DepartmentOfAlchemy/Codex43/board/Codex43/Codex43.kicad_pcb

## KiCad design board/Codex43/Codex43.kicad_pcb (2024-08-17)

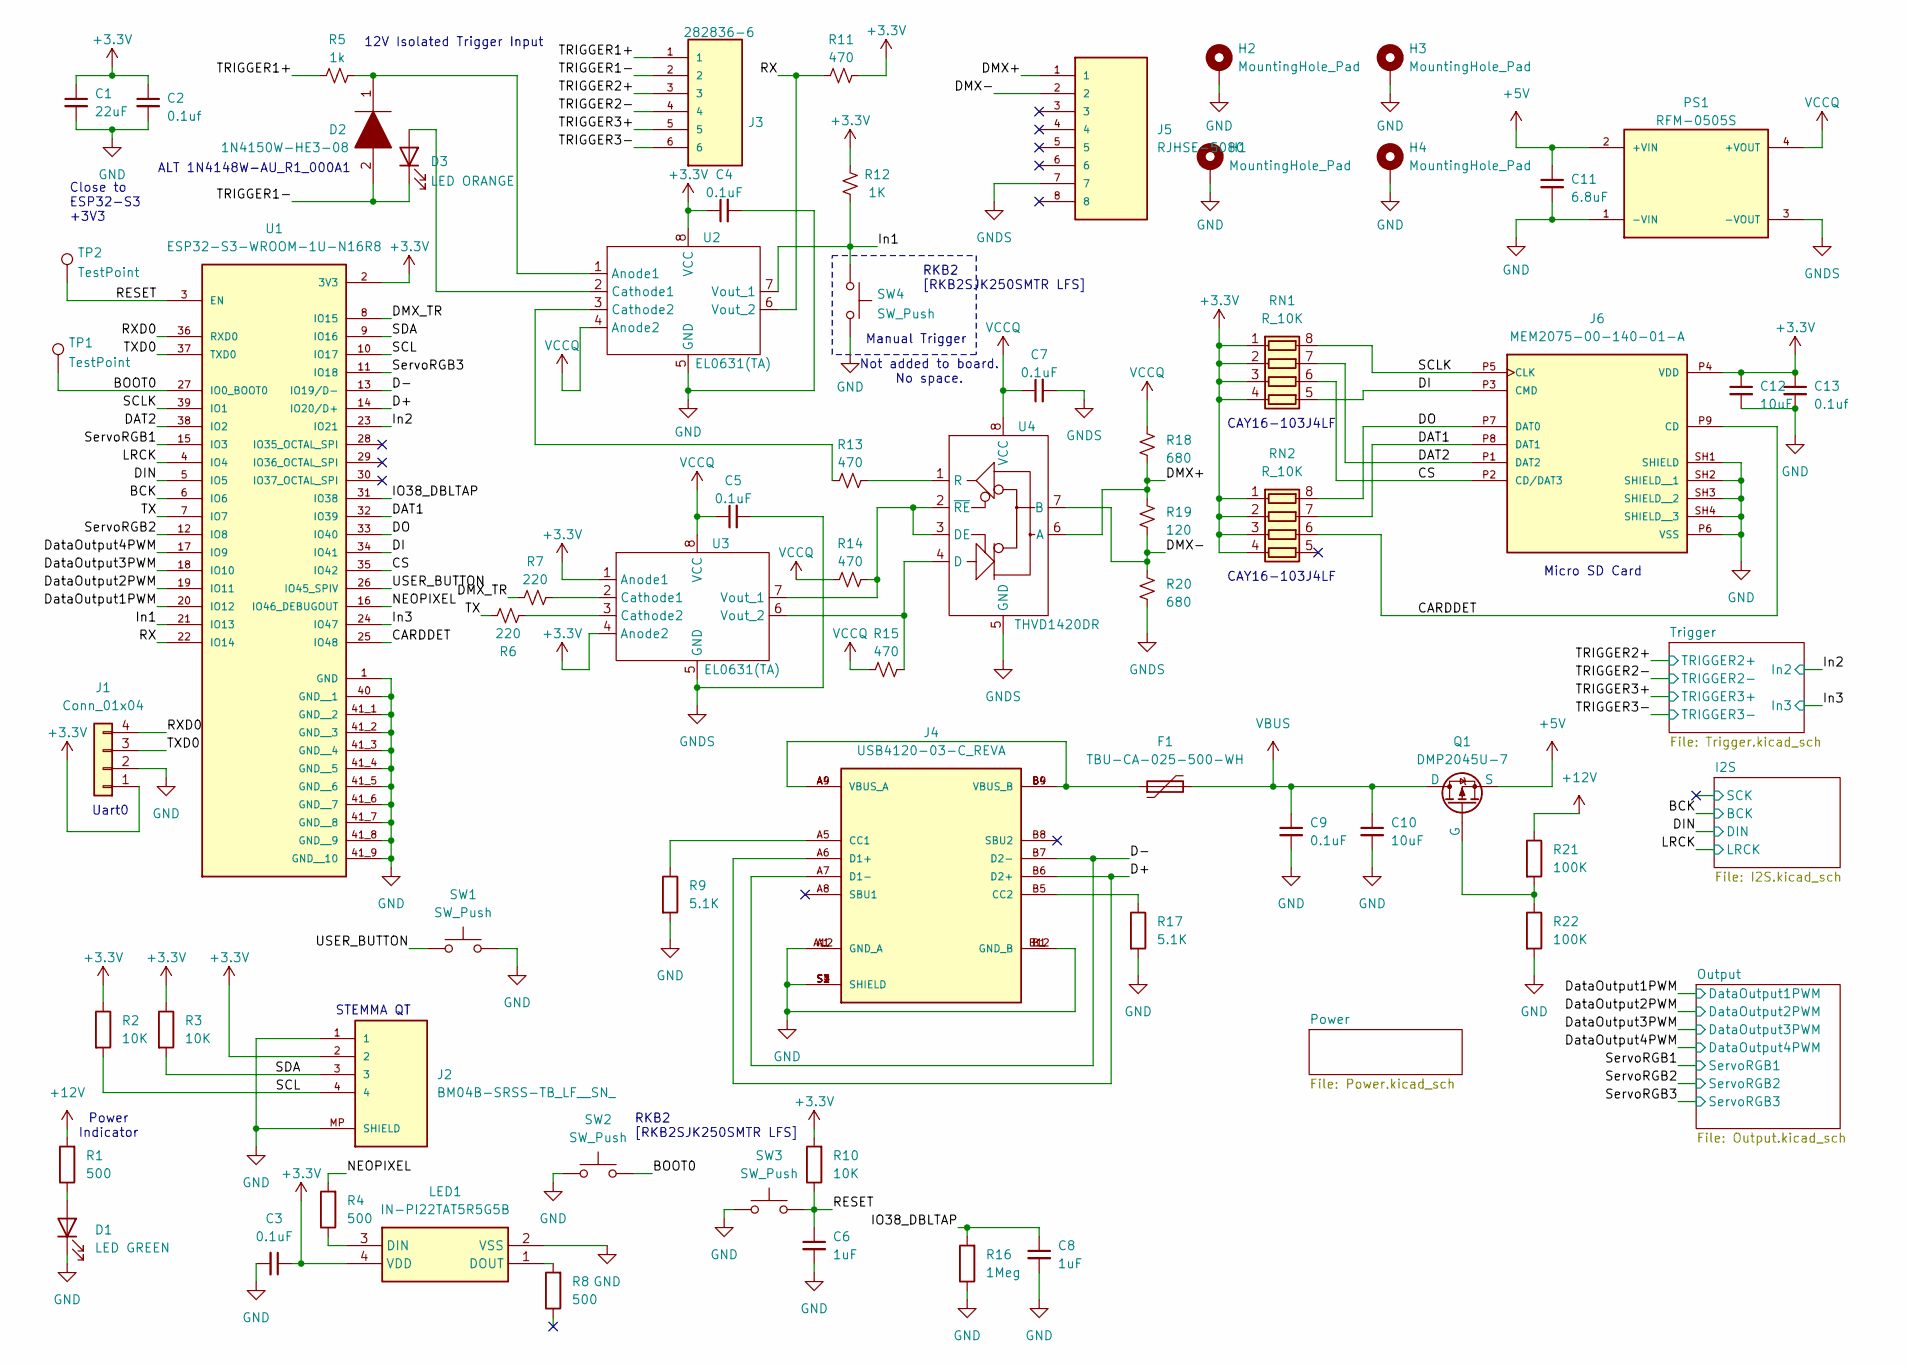
[picture p1: schematic Codex43.kicad_sch, Codex 43]

Parts:
C1: 22uF; C_0805_2012Metric
C2, C13: 0.1uf; C_0603_1608Metric
C3, C4, C5, C7, C9: 0.1uF; C_0603_1608Metric
C6, C8: 1uF; C_0603_1608Metric
C10, C12: 10uF; C_0805_2012Metric
C11: 6.8uF; C_0805_2012Metric
D1: LED GREEN; LED_0603_1608Metric
D2: 1N4150W-HE3-08; D_SOD-123; Manufacturer_Part_Number S1GTR
D3: LED ORANGE; LED_0603_1608Metric
F1: TBU-CA-025-500-WH; Fuse_Bourns_TBU-CA
H1, H2, H3, H4: MountingHole_Pad; MountingHole_3.2mm_M3_ISO7380_Pad_TopBottom
J1: Conn_01x04; PinHeader_1x04_P2.54mm_Vertical
J2: BM04B-SRSS-TB_LF__SN_; JST_SH_BM04B-SRSS-TB_1x04-1MP_P1.00mm_Vertical; PARTREV N/A
J3: 282836-6; TE_282836-6; PARTREV J1
J4: USB4120-03-C_REVA; GCT_USB4120-03-C_REVA; PARTREV A
J5: RJHSE-5080; AMPHENOL_RJHSE-5080; PARTREV G
J6: MEM2075-00-140-01-A; GCT_MEM2075-00-140-01-A; PARTREV A
LED1: IN-PI22TAT5R5G5B; INPI22TAT5R5G5B; Mouser Part Number 743-IN-PI22TAT5R5G5B
PS1: RFM-0505S; CONV_RFM-0505S; PARTREV 0
Q1: DMP2045U-7; SOT-23_DIO
R1, R4, R8: 500; R_0603_1608Metric
R2, R3, R10: 10K; R_0603_1608Metric
R5: 1k; R_0603_1608Metric
R6, R7: 220; R_0603_1608Metric
R9, R17: 5.1K; R_0603_1608Metric
R11, R13, R14, R15: 470; R_0603_1608Metric
R12: 1K; R_0603_1608Metric
R16: 1Meg; R_0603_1608Metric
R18, R20: 680; R_0603_1608Metric
R19: 120; R_0603_1608Metric
R21, R22: 100K; R_0603_1608Metric
RN1, RN2: R_10K; R_Array_Convex_4x0603
SW1, SW2, SW3, SW4: SW_Push; SW_Push_1P1T_NO_RKB2SJK250SMTR LFS
TP1, TP2: TestPoint; TestPoint_Pad_D2.5mm
U1: ESP32-S3-WROOM-1U-N16R8; XCVR_ESP32-S3-WROOM-1U-N16R8; PARTREV v1.1
U2, U3: EL0631(TA); EL0631(TA)-SOP-8_3.9x4.9mm_P1.27mm
U4: THVD1420DR; SOIC-8-TE_3.9x4.9mm_P1.27mm

Connections:
+3.3V: C1.1, C2.1, C3.1, C4.1, C12.1, C13.1, J1.1, J2.2, J6.P4 (VDD), LED1.4 (VDD), R2.1, R3.1, R10.2, R11.1, R12.2, RN1.1 (R1.1), RN1.2 (R2.1), RN1.3 (R3.1), RN1.4 (R4.1), RN2.1 (R1.1), RN2.2 (R2.1), RN2.3 (R3.1), RN2.4 (R4.1), U1.2 (3V3), U2.8 (VCC), U3.1 (Anode1), U3.4 (Anode2); also elsewhere on the board
+5V: C11.1, PS1.2 (+VIN), Q1.2 (S); also elsewhere on the board
+12V: R1.2, R21.1; also elsewhere on the board
/BCK: U1.6 (IO6); also elsewhere on the board
/BOOT0: SW2.2, TP1.1, U1.27 (IO0_BOOT0)
/CARDDET: J6.P9 (CD), RN2.6 (R3.2), U1.25 (IO48)
/CS: J6.P2 (CD/DAT3), RN1.6 (R3.2), U1.35 (IO42)
/D+: J4.A6 (D1+), J4.B6 (D2+), U1.14 (IO20/D+)
/D-: J4.A7 (D1-), J4.B7 (D2-), U1.13 (IO19/D-)
/DAT1: J6.P8 (DAT1), RN2.7 (R2.2), U1.32 (IO39)
/DAT2: J6.P1 (DAT2), RN1.7 (R2.2), U1.38 (IO2)
/DI: J6.P3 (CMD), RN1.5 (R4.2), U1.34 (IO41)
/DIN: U1.5 (IO5); also elsewhere on the board
/DMX+: J5.1, R18.2, R19.1, U4.6 (A)
/DMX-: J5.2, R19.2, R20.1, U4.7 (B)
/DMX_TR: R7.2, U1.8 (IO15)
/DO: J6.P7 (DAT0), RN2.8 (R1.2), U1.33 (IO40)
/DataOutput1PWM: U1.20 (IO12); also elsewhere on the board
/DataOutput2PWM: U1.19 (IO11); also elsewhere on the board
/DataOutput3PWM: U1.18 (IO10); also elsewhere on the board
/DataOutput4PWM: U1.17 (IO9); also elsewhere on the board
/IO38_DBLTAP: C8.1, R16.2, U1.31 (IO38)
/In1: R12.1, SW4.1, U1.21 (IO13), U2.7 (Vout_1)
/In2: U1.23 (IO21); also elsewhere on the board
/In3: U1.24 (IO47); also elsewhere on the board
/LRCK: U1.4 (IO4); also elsewhere on the board
/NEOPIXEL: R4.2, U1.16 (IO46_DEBUGOUT)
/RESET: C6.1, R10.1, SW3.2, TP2.1, U1.3 (EN)
/RX: R11.2, U1.22 (IO14), U2.6 (Vout_2)
/RXD0: J1.4, U1.36 (RXD0)
/SCL: J2.4, R2.2, U1.10 (IO17)
/SCLK: J6.P5 (CLK), RN1.8 (R1.2), U1.39 (IO1)
/SDA: J2.3, R3.2, U1.9 (IO16)
/ServoRGB1: U1.15 (IO3); also elsewhere on the board
/ServoRGB2: U1.12 (IO8); also elsewhere on the board
/ServoRGB3: U1.11 (IO18); also elsewhere on the board
/TRIGGER1+: J3.1, R5.2
/TRIGGER1-: D2.2, D3.1 (K), J3.2
/TRIGGER2+: J3.3; also elsewhere on the board
/TRIGGER2-: J3.4; also elsewhere on the board
/TRIGGER3+: J3.5; also elsewhere on the board
/TRIGGER3-: J3.6; also elsewhere on the board
/TX: R6.2, U1.7 (IO7)
/TXD0: J1.3, U1.37 (TXD0)
/USER_BUTTON: SW1.1, U1.26 (IO45_SPIV)
GND: C1.2, C2.2, C3.2, C4.2, C6.2, C8.2, C9.2, C10.2, C11.2, C12.2, C13.2, D1.1 (K), H1.1, H2.1, H3.1, H4.1, J1.2, J2.1, J2.MP (SHIELD), J4.A1 (GND_A), J4.A12 (GND_A), J4.B1 (GND_B), J4.B12 (GND_B), J4.S1 (SHIELD), J4.S2 (SHIELD), J4.S3 (SHIELD), J4.S4 (SHIELD), J6.P6 (VSS), J6.SH1 (SHIELD), J6.SH2 (SHIELD__1), J6.SH3 (SHIELD__2), J6.SH4 (SHIELD__3), LED1.2 (VSS), PS1.1 (-VIN), R9.2, R16.1, R17.2, R22.2, SW1.2, SW2.1, SW3.1, SW4.2, U1.1 (GND), U1.40 (GND__1), U1.41_1 (GND__2), U1.41_2 (GND__3), U1.41_3 (GND__4), U1.41_4 (GND__5), U1.41_5 (GND__6), U1.41_6 (GND__7), U1.41_7 (GND__8), U1.41_8 (GND__9), U1.41_9 (GND__10), U2.5 (GND); also elsewhere on the board
GNDS: C5.2, C7.2, J5.7, PS1.3 (-VOUT), R20.2, U3.5 (GND), U4.5 (GND)
unnamed: D1.2 (A), R1.1
unnamed: D3.2 (A), U2.2 (Cathode1)
unnamed: F1.1, J4.A4 (VBUS_A), J4.A9 (VBUS_A), J4.B4 (VBUS_B), J4.B9 (VBUS_B)
unnamed: J4.A5 (CC1), R9.1
unnamed: J4.B5 (CC2), R17.1
unnamed: LED1.3 (DIN), R4.1
unnamed: LED1.1 (DOUT), R8.2
unnamed: Q1.1 (G), R21.2, R22.1
unnamed: D2.1, R5.1, U2.1 (Anode1)
unnamed: R13.2, U2.3 (Cathode2)
unnamed: R7.1, U3.2 (Cathode1)
unnamed: R6.1, U3.3 (Cathode2)
unnamed: R14.1, U3.7 (Vout_1), U4.2 (~RE), U4.3 (DE)
unnamed: R15.1, U3.6 (Vout_2), U4.4 (D)
unnamed: R13.1, U4.1 (R)
VBUS: C9.1, C10.1, F1.3, Q1.3 (D)
VCCQ: C5.1, C7.1, PS1.4 (+VOUT), R14.2, R15.2, R18.1, U2.4 (Anode2), U3.8 (VCC), U4.8 (VCC)

Notes on the sheet:
RKB2 [RKB2SJK250SMTR LFS]
CAY16-103J4LF
Manual Trigger
Micro SD Card
Not added to board. No space.
Power Indicator
Close to ESP32-S3 +3V3
STEMMA QT
12V Isolated Trigger Input
ALT 1N4148W-AU_R1_000A1
Uart0

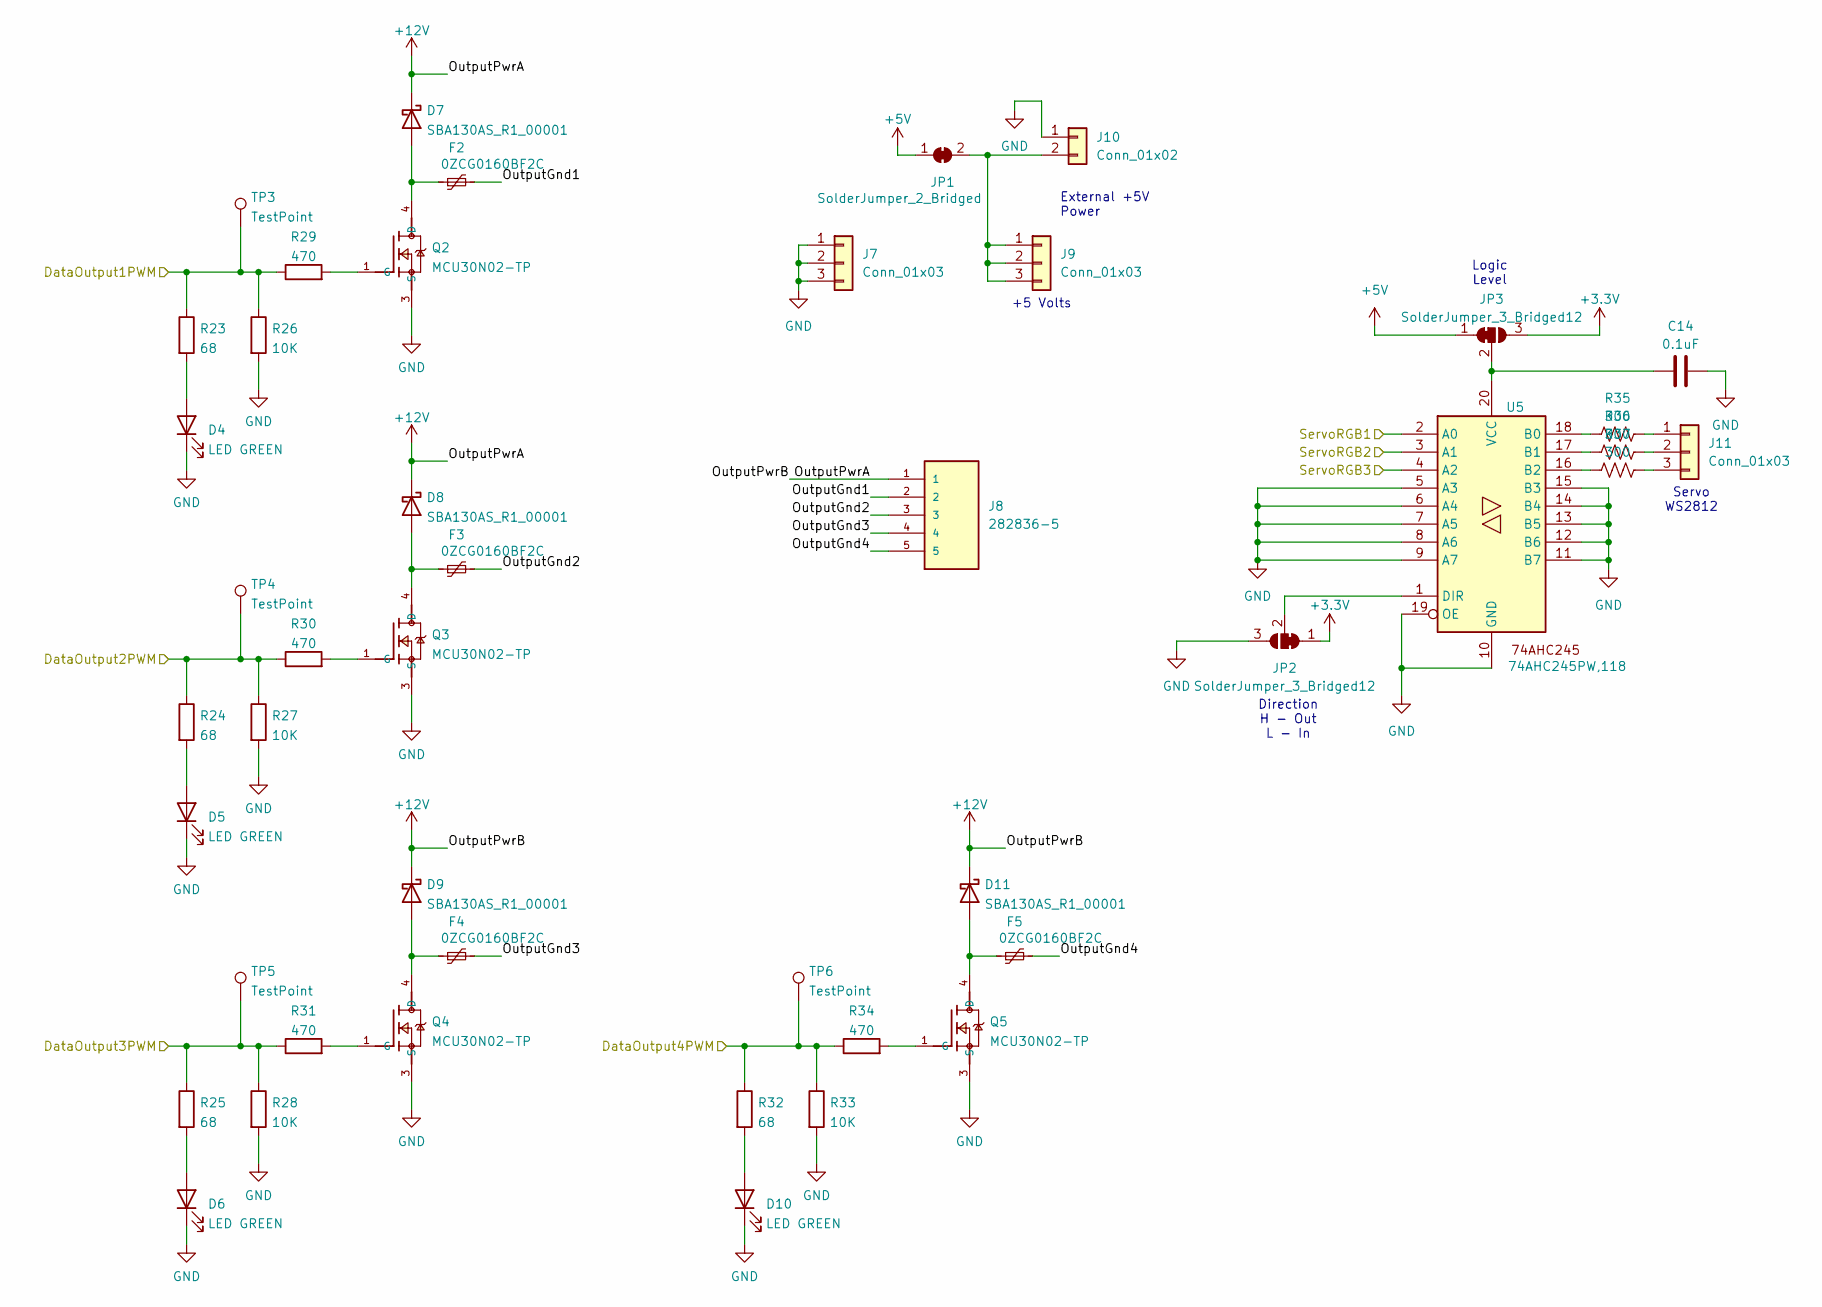
[picture p2: schematic Output.kicad_sch, Codex 43]

Parts:
C14: 0.1uF; C_0805_2012Metric_Pad1.18x1.45mm_HandSolder
D4, D5, D6, D10: LED GREEN; LED_0603_1608Metric
D7, D8, D9, D11: SBA130AS_R1_00001; D_SOD-123
F2, F3, F4, F5: 0ZCG0160BF2C; Fuse_1812_4532Metric
J7, J9, J11: Conn_01x03; PinHeader_1x03_P2.54mm_Vertical
J8: 282836-5; TE_282836-5; PARTREV J1
J10: Conn_01x02; PinHeader_1x02_P2.54mm_Vertical
JP1: SolderJumper_2_Bridged; SolderJumper-2_P1.3mm_Bridged_Pad1.0x1.5mm
JP2, JP3: SolderJumper_3_Bridged12; SolderJumper-3_P1.3mm_Bridged12_Pad1.0x1.5mm
Q2, Q3, Q4, Q5: MCU30N02-TP; TO229P991X239-3N
R23, R24, R25, R32: 68; R_0603_1608Metric
R26, R27, R28, R33: 10K; R_0603_1608Metric
R29, R30, R31, R34: 470; R_0603_1608Metric
R35, R36, R37: 300; R_0603_1608Metric
TP3, TP4, TP5, TP6: TestPoint; TestPoint_Pad_D2.5mm
U5: 74AHC245PW,118; SOP65P640X120-20N

Connections:
+3.3V: JP2.1 (A), JP3.3 (B); also elsewhere on the board
+5V: JP1.1 (A), JP3.1 (A); also elsewhere on the board
+12V: D7.1 (K), D8.1 (K), D9.1 (K), D11.1 (K), J8.1; also elsewhere on the board
/DataOutput1PWM: R23.1, R26.1, R29.1, TP3.1; also elsewhere on the board
/DataOutput2PWM: R24.1, R27.1, R30.1, TP4.1; also elsewhere on the board
/DataOutput3PWM: R25.1, R28.1, R31.1, TP5.1; also elsewhere on the board
/DataOutput4PWM: R32.1, R33.1, R34.1, TP6.1; also elsewhere on the board
/Output/OutputGnd1: F2.2, J8.2
/Output/OutputGnd2: F3.2, J8.3
/Output/OutputGnd3: F4.2, J8.4
/Output/OutputGnd4: F5.2, J8.5
/ServoRGB1: U5.2 (A0); also elsewhere on the board
/ServoRGB2: U5.3 (A1); also elsewhere on the board
/ServoRGB3: U5.4 (A2); also elsewhere on the board
GND: C14.2, D4.1 (K), D5.1 (K), D6.1 (K), D10.1 (K), J7.1, J7.2, J7.3, J10.1, JP2.3 (B), Q2.3 (S), Q3.3 (S), Q4.3 (S), Q5.3 (S), R26.2, R27.2, R28.2, R33.2, U5.5 (A3), U5.6 (A4), U5.7 (A5), U5.8 (A6), U5.9 (A7), U5.10 (GND), U5.11 (B7), U5.12 (B6), U5.13 (B5), U5.14 (B4), U5.15 (B3), U5.19 (OE); also elsewhere on the board
unnamed: D4.2 (A), R23.2
unnamed: D5.2 (A), R24.2
unnamed: D6.2 (A), R25.2
unnamed: D7.2 (A), F2.1, Q2.4 (D)
unnamed: D8.2 (A), F3.1, Q3.4 (D)
unnamed: D9.2 (A), F4.1, Q4.4 (D)
unnamed: D10.2 (A), R32.2
unnamed: D11.2 (A), F5.1, Q5.4 (D)
unnamed: J9.1, J9.2, J9.3, J10.2, JP1.2 (B)
unnamed: J11.1, R35.2
unnamed: J11.2, R36.2
unnamed: J11.3, R37.2
unnamed: JP2.2 (C), U5.1 (DIR)
unnamed: C14.1, JP3.2 (C), U5.20 (VCC)
unnamed: Q2.1 (G), R29.2
unnamed: Q3.1 (G), R30.2
unnamed: Q4.1 (G), R31.2
unnamed: Q5.1 (G), R34.2
unnamed: R35.1, U5.18 (B0)
unnamed: R36.1, U5.17 (B1)
unnamed: R37.1, U5.16 (B2)

Notes on the sheet:
+5 Volts
External +5V Power
Direction H - Out L - In
Servo WS2812
Logic Level

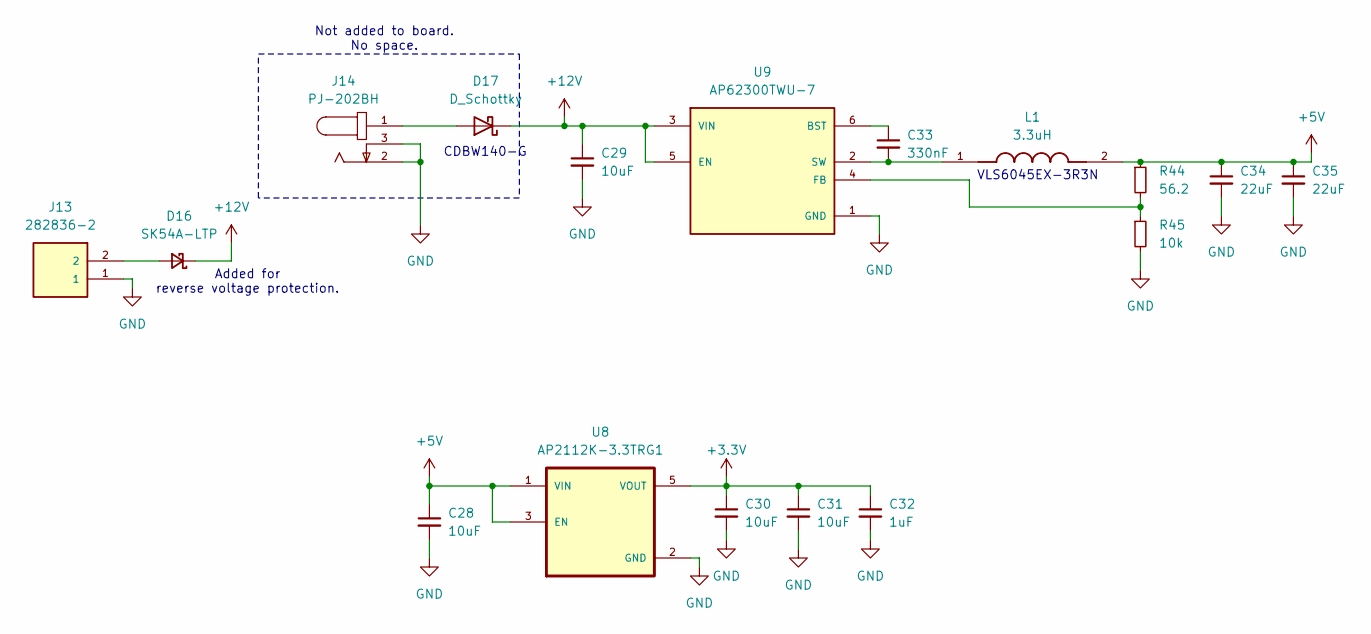
[picture p3: schematic Power.kicad_sch, Codex 43]

Parts:
C28, C29, C30, C31: 10uF; C_0805_2012Metric
C32: 1uF; C_0603_1608Metric
C33: 330nF; C_0603_1608Metric
C34, C35: 22uF; C_0805_2012Metric
D16: SK54A-LTP; D_SMA Modified
D17: D_Schottky; D_SOD-123
J13: 282836-2; TE_282836-2; PARTREV J1
J14: PJ-202BH; CUI_PJ-202BH; PART_REV 1.02
L1: 3.3uH; VLS6045EX-3R3N; PARTREV N/A
R44: 56.2; R_0603_1608Metric
R45: 10k; R_0603_1608Metric
U8: AP2112K-3.3TRG1; SOT95P285X140-5N; PARTREV 2-2
U9: AP62300TWU-7; SOT95P280X100-6N; PARTREV Rev. 3 - 2

Connections:
+3.3V: C30.1, C31.1, C32.1, U8.5 (VOUT); also elsewhere on the board
+5V: C28.1, C34.1, C35.1, L1.2, R44.1, U8.1 (VIN), U8.3 (EN); also elsewhere on the board
+12V: C29.1, D16.1 (K), D17.1 (K), U9.3 (VIN), U9.5 (EN); also elsewhere on the board
GND: C28.2, C29.2, C30.2, C31.2, C32.2, C34.2, C35.2, J13.1, J14.2, J14.3, R45.2, U8.2 (GND), U9.1 (GND); also elsewhere on the board
unnamed: D16.2 (A), J13.2
unnamed: D17.2 (A), J14.1
unnamed: C33.1, U9.6 (BST)
unnamed: R44.2, R45.1, U9.4 (FB)
unnamed: C33.2, L1.1, U9.2 (SW)

Notes on the sheet:
VLS6045EX-3R3N
Added for reverse voltage protection.
Not added to board. No space.
CDBW140-G

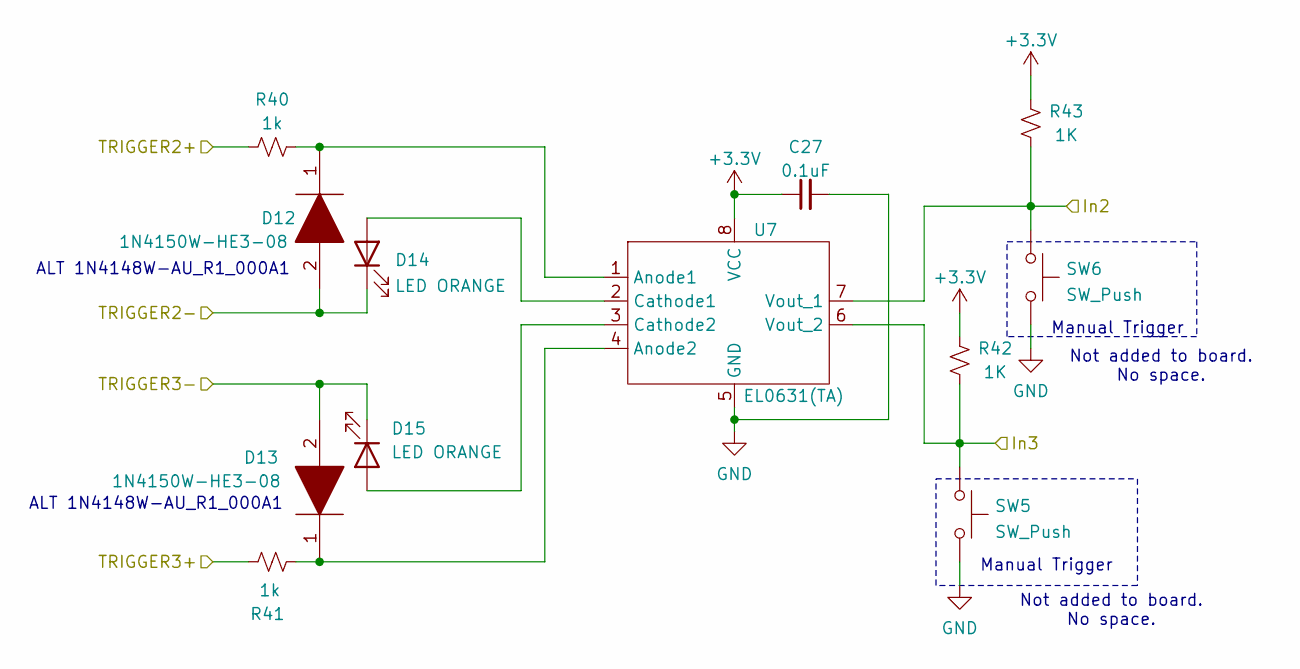
[picture p4: schematic Trigger.kicad_sch, Codex 43]

Parts:
C27: 0.1uF; C_0603_1608Metric
D12, D13: 1N4150W-HE3-08; D_SOD-123; Manufacturer_Part_Number S1GTR
D14, D15: LED ORANGE; LED_0603_1608Metric
R40, R41: 1k; R_0603_1608Metric
R42, R43: 1K; R_0603_1608Metric
SW5, SW6: SW_Push; SW_Push_1P1T_NO_RKB2SJK250SMTR LFS
U7: EL0631(TA); EL0631(TA)-SOP-8_3.9x4.9mm_P1.27mm

Connections:
+3.3V: C27.1, R42.2, R43.2, U7.8 (VCC); also elsewhere on the board
/In2: R43.1, SW6.1, U7.7 (Vout_1); also elsewhere on the board
/In3: R42.1, SW5.1, U7.6 (Vout_2); also elsewhere on the board
/TRIGGER2+: R40.2; also elsewhere on the board
/TRIGGER2-: D12.2, D14.1 (K); also elsewhere on the board
/TRIGGER3+: R41.2; also elsewhere on the board
/TRIGGER3-: D13.2, D15.1 (K); also elsewhere on the board
GND: C27.2, SW5.2, SW6.2, U7.5 (GND); also elsewhere on the board
unnamed: D14.2 (A), U7.2 (Cathode1)
unnamed: D15.2 (A), U7.3 (Cathode2)
unnamed: D12.1, R40.1, U7.1 (Anode1)
unnamed: D13.1, R41.1, U7.4 (Anode2)

Notes on the sheet:
ALT 1N4148W-AU_R1_000A1
Not added to board. No space.
Manual Trigger

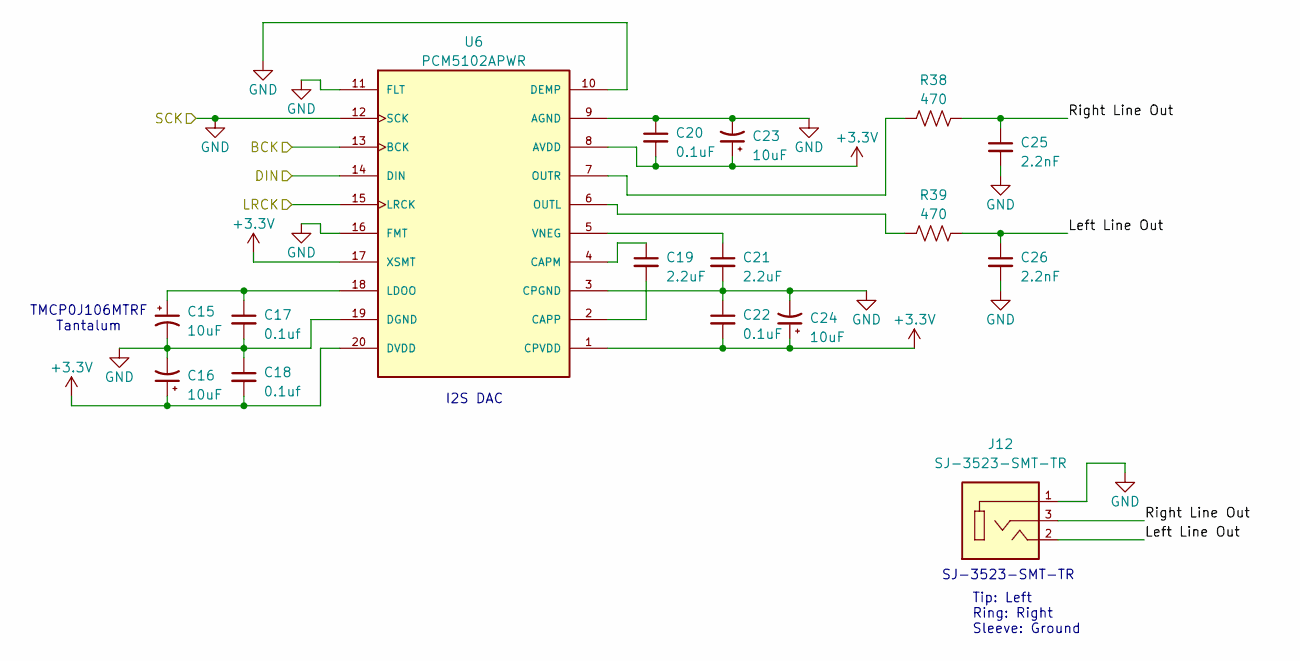
[picture p5: schematic I2S.kicad_sch, Codex 43]

Parts:
C15, C16, C23, C24: 10uF; CAPPM2012X120N
C17, C18: 0.1uf; C_0603_1608Metric
C19, C21: 2.2uF; C_0603_1608Metric
C20, C22: 0.1uF; C_0603_1608Metric
C25, C26: 2.2nF; C_0603_1608Metric
J12: SJ-3523-SMT-TR; CUI_SJ-3523-SMT-TR
R38, R39: 470; R_0603_1608Metric
U6: PCM5102APWR; SOP65P640X120-20N; PARTREV C

Connections:
+3.3V: C16.1, C18.2, C20.2, C22.2, C23.1, C24.1, U6.1 (CPVDD), U6.8 (AVDD), U6.17 (XSMT), U6.20 (DVDD); also elsewhere on the board
/BCK: U6.13 (BCK); also elsewhere on the board
/DIN: U6.14 (DIN); also elsewhere on the board
/I2S/Left Line Out: C26.1, J12.2, R39.2
/I2S/Right Line Out: C25.1, J12.3, R38.2
/LRCK: U6.15 (LRCK); also elsewhere on the board
GND: C15.2, C16.2, C17.2, C18.1, C20.1, C21.2, C22.1, C23.2, C24.2, C25.2, C26.2, J12.1, U6.3 (CPGND), U6.9 (AGND), U6.10 (DEMP), U6.11 (FLT), U6.12 (SCK), U6.16 (FMT), U6.19 (DGND); also elsewhere on the board
unnamed: C19.1, U6.4 (CAPM)
unnamed: C19.2, U6.2 (CAPP)
unnamed: C15.1, C17.1, U6.18 (LDOO)
unnamed: R39.1, U6.6 (OUTL)
unnamed: R38.1, U6.7 (OUTR)
unnamed: C21.1, U6.5 (VNEG)

Notes on the sheet:
Tip: Left Ring: Right Sleeve: Ground
SJ-3523-SMT-TR
I2S DAC
TMCP0J106MTRF Tantalum

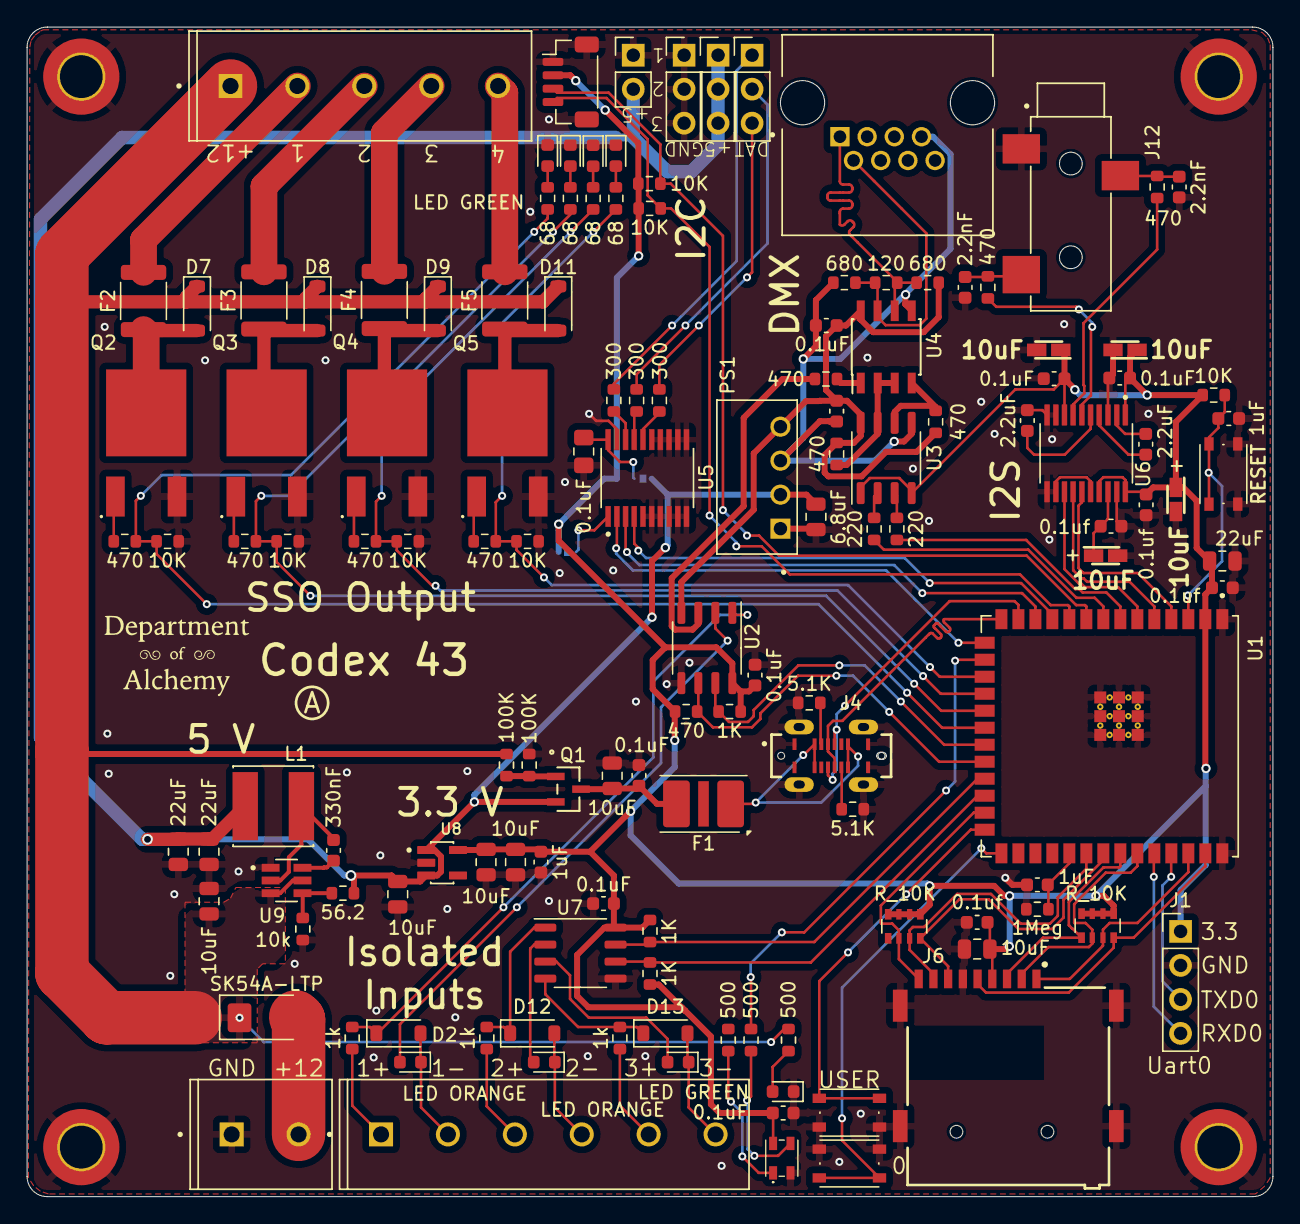
[picture p6: board Codex43.kicad_pcb from above]

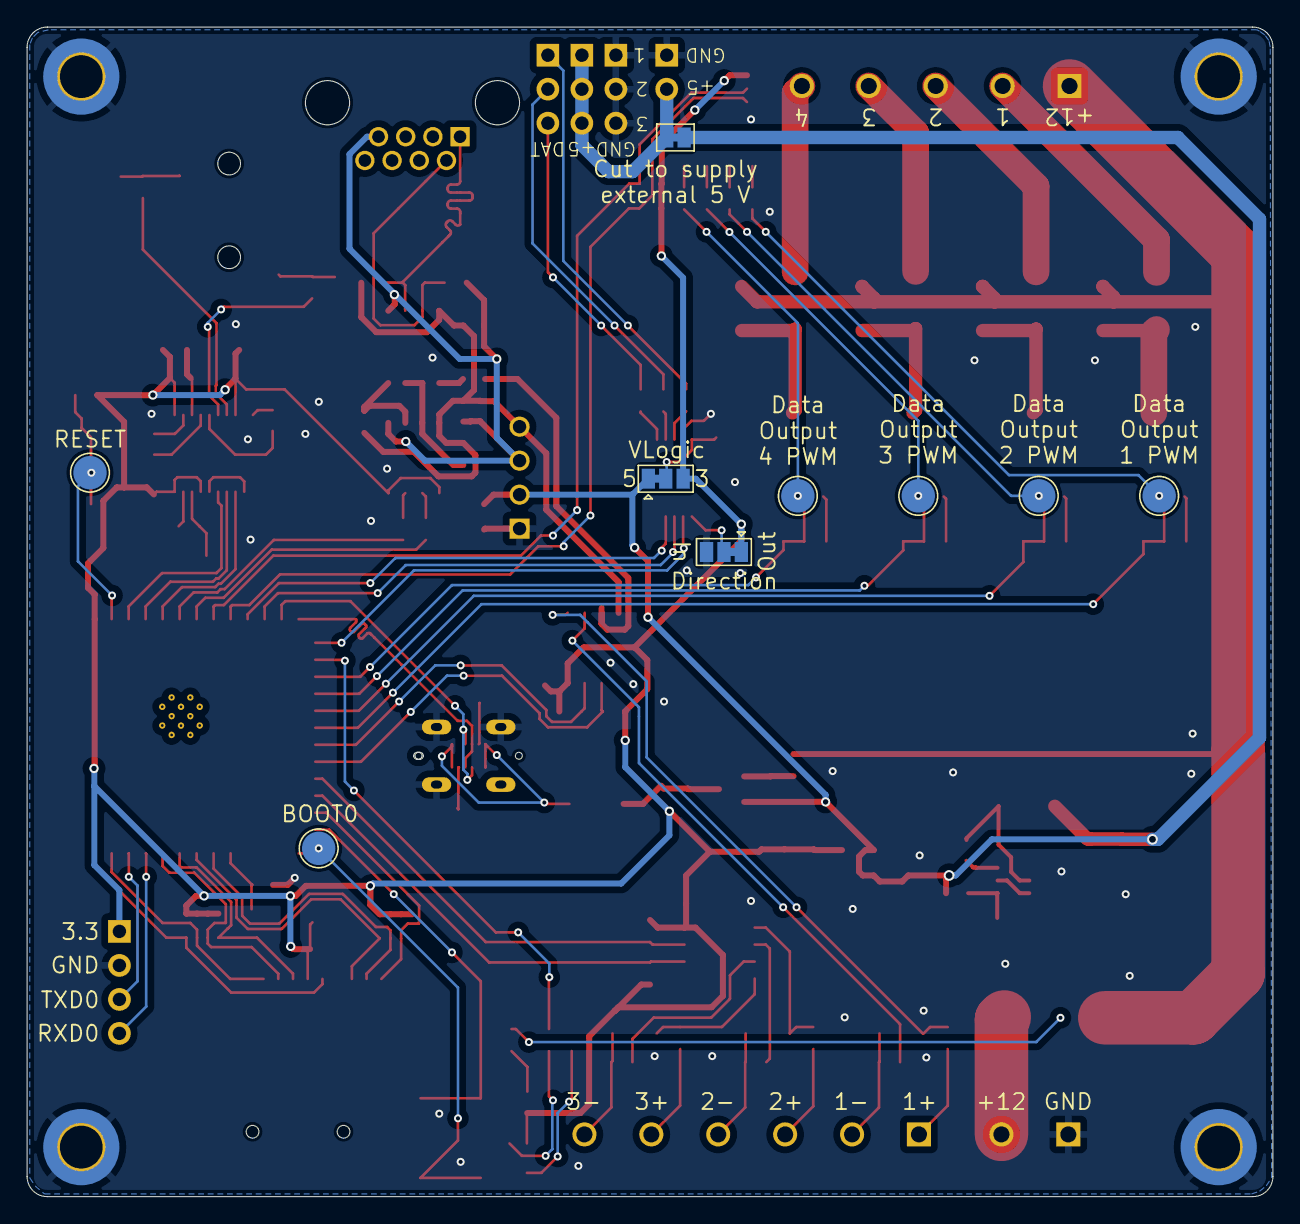
[picture p7: board Codex43.kicad_pcb from below]

Board: 2 copper layers, 93.1 x 87.4 mm, 149 parts (9 on the bottom side), 105 nets.
